M0WUT/KIO_WUT/Hardware/usb_hub_test.brd

## EAGLE design Hardware/usb_hub_test.brd (2019-03-14)

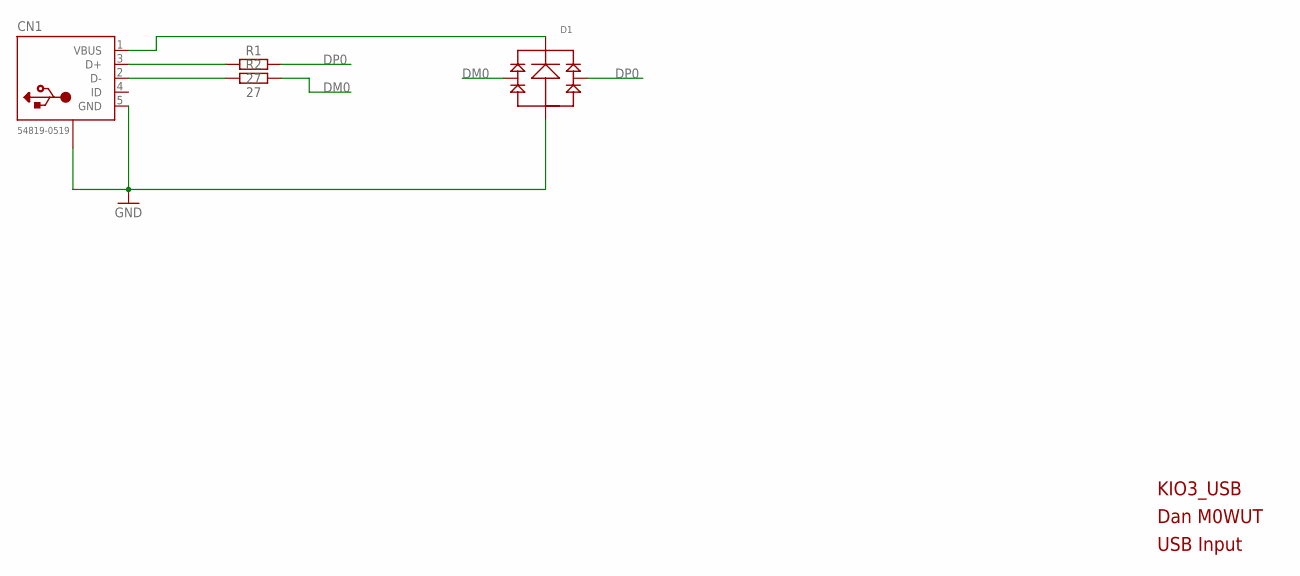
[picture p1: schematic usb_hub_test.sch, sheet 1, USB Input]

Parts:
CN1: 54819-0519; CONN_AMP_MUSB_K152
D1: D_ST_USBULC6; UQFN6
R1, R2: 27; R0402

Connections:
D+_P: CN1.3 (D+), R1.1
DM0: D1.1 (LEFT), D1.6 (LEFT), R2.2; also elsewhere on the board
DP0: D1.3 (RIGHT), D1.4 (RIGHT), R1.2; also elsewhere on the board
GND: CN1.5 (GND), CN1.GND1 (SHIELD), CN1.GND2 (SHIELD), D1.2 (GND); also elsewhere on the board
unnamed: CN1.2 (D-), R2.1
VBUS: CN1.1 (VBUS), D1.5 (V+)

Notes on the sheet:
KIO3_USB
Dan M0WUT
USB Input

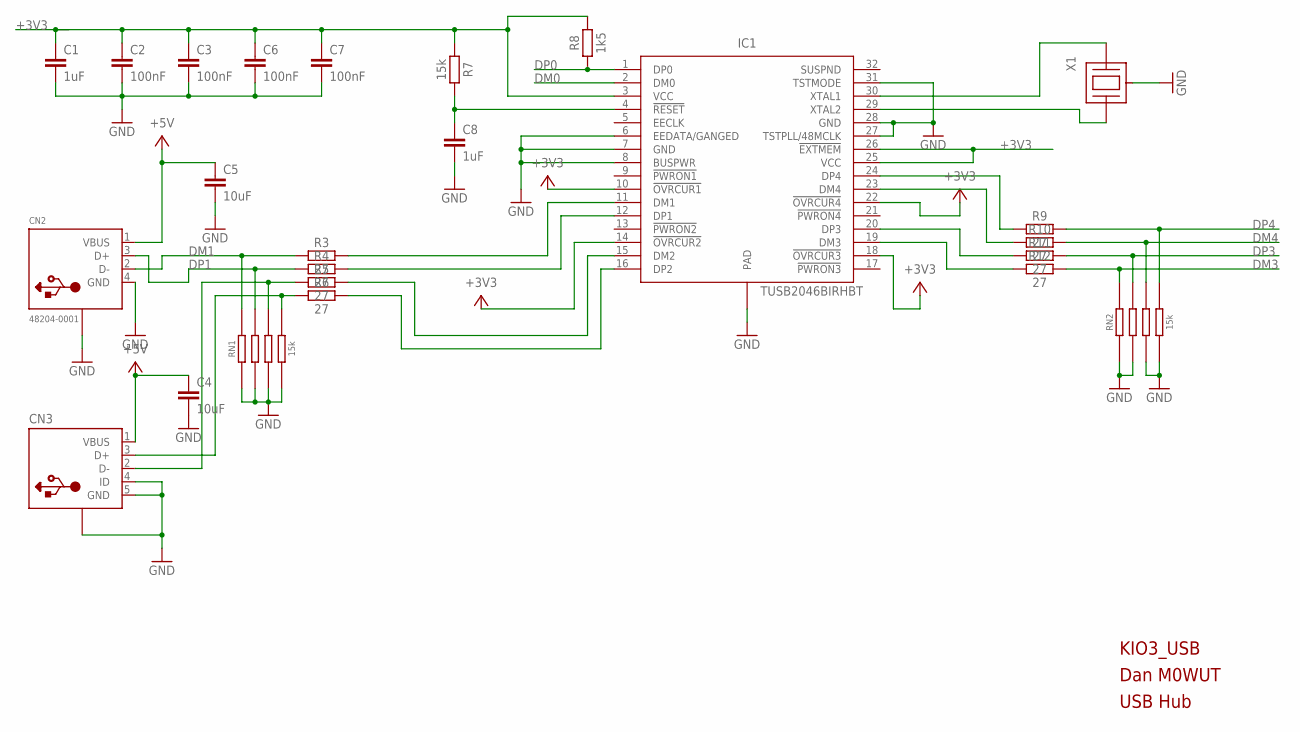
[picture p2: schematic usb_hub_test.sch, sheet 2, USB Hub]

Parts:
C1, C8: 1uF; C0402
C2, C3, C6, C7: 100nF; C0402
C4, C5: 10uF; C0805
CN2: 48204-0001; CONN_USB_MOLEX_RA
CN3: USBWURTH; USB_MICROB_WURTH
IC1: TUSB2046BIRHBT; RHB_S-PQFP-N32
R3, R4, R5, R6, R9, R10, R11, R12: 27; R0402
R7: 15k; R0402
R8: 1k5; R0402
RN1, RN2: 15k; R_BOURNS_CAY16-J4
X1: XTAL_MURATA_3-PIN-RES

Connections:
+3V3: C1.1, C2.1, C3.1, C6.1, C7.1, IC1.3 (VCC), IC1.10 (!OVRCUR1), IC1.14 (!OVRCUR2), IC1.18 (!OVRCUR3), IC1.22 (!OVRCUR4), IC1.25 (VCC), IC1.26 (!EXTMEM), R7.1, R8.2; also elsewhere on the board
+5V: C4.1, C5.1, CN2.1 (VBUS), CN3.1 (VBUS); also elsewhere on the board
DM0: IC1.2 (DM0); also elsewhere on the board
DM1: CN2.2 (D-), R3.1, RN1.1A
DM2: CN3.2 (D-), R5.1, RN1.3A
DM3: R12.2, RN2.1A; also elsewhere on the board
DM4: R10.2, RN2.3A; also elsewhere on the board
DP0: IC1.1 (DP0), R8.1; also elsewhere on the board
DP1: CN2.3 (D+), R4.1, RN1.2A
DP2: CN3.3 (D+), R6.1, RN1.4A
DP3: R11.2, RN2.2A; also elsewhere on the board
DP4: R9.2, RN2.4A; also elsewhere on the board
GND: C1.2, C2.2, C3.2, C4.2, C5.2, C6.2, C7.2, C8.2, CN2.4 (GND), CN2.P$2 (SHIELD), CN2.P$3 (SHIELD), CN2.P$4 (SHIELD), CN2.P$5 (SHIELD), CN3.4 (ID), CN3.5 (GND), CN3.GND1 (SHIELD), CN3.GND2 (SHIELD), CN3.GND3 (SHIELD), CN3.GND4 (SHIELD), IC1.6 (EEDATA/GANGED), IC1.7 (GND), IC1.8 (BUSPWR), IC1.27 (TSTPLL/48MCLK), IC1.28 (GND), IC1.31 (TSTMODE), IC1.EXP (PAD), RN1.1, RN1.2, RN1.3, RN1.4, RN2.1, RN2.2, RN2.3, RN2.4, X1.GND (CAN); also elsewhere on the board
unnamed: IC1.23 (DM4), R10.1
unnamed: IC1.24 (DP4), R9.1
unnamed: IC1.30 (XTAL1), X1.1 (XTAL1)
unnamed: C8.1, IC1.4 (!RESET), R7.2
unnamed: IC1.29 (XTAL2), X1.2 (XTAL2)
unnamed: IC1.15 (DM2), R5.2
unnamed: IC1.11 (DM1), R3.2
unnamed: IC1.12 (DP1), R4.2
unnamed: IC1.16 (DP2), R6.2
unnamed: IC1.20 (DP3), R11.1
unnamed: IC1.19 (DM3), R12.1

Notes on the sheet:
KIO3_USB
Dan M0WUT
USB Hub

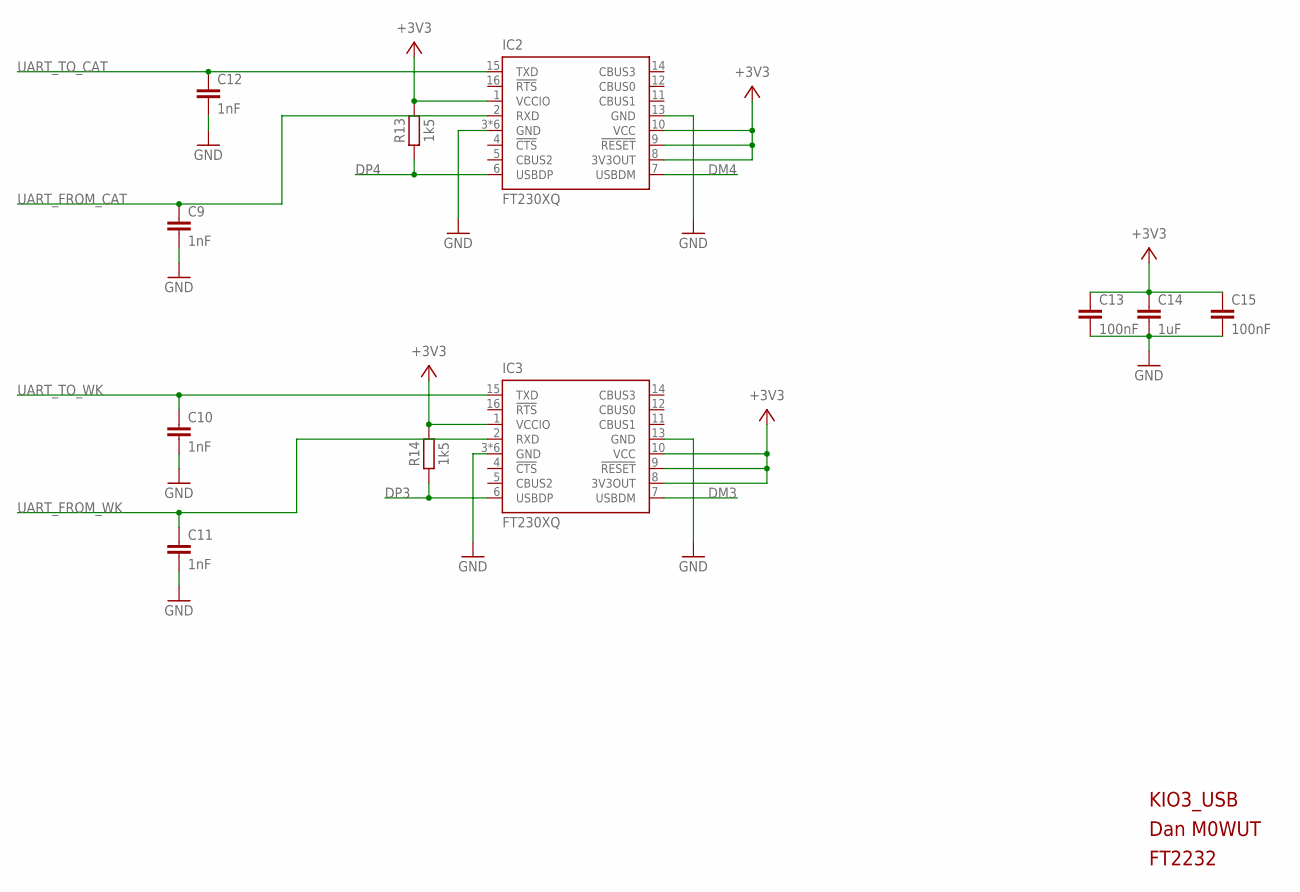
[picture p3: schematic usb_hub_test.sch, sheet 3, FT2232]

Parts:
C9, C10, C11, C12: 1nF; C0402
C13, C15: 100nF; C0402
C14: 1uF; C0402
IC2, IC3: FT230XQ; QFN16
R13, R14: 1k5; R0402

Connections:
+3V3: C13.1, C14.1, C15.1, IC2.1 (VCCIO), IC2.8 (3V3OUT), IC2.9 (!RESET), IC2.10 (VCC), IC3.1 (VCCIO), IC3.8 (3V3OUT), IC3.9 (!RESET), IC3.10 (VCC), R13.2, R14.2; also elsewhere on the board
DM3: IC3.7 (USBDM); also elsewhere on the board
DM4: IC2.7 (USBDM); also elsewhere on the board
DP3: IC3.6 (USBDP), R14.1; also elsewhere on the board
DP4: IC2.6 (USBDP), R13.1; also elsewhere on the board
GND: C9.2, C10.2, C11.2, C12.2, C13.2, C14.2, C15.2, IC2.3 (GND), IC2.13 (GND), IC2.P$1 (GND), IC2.P$2 (GND), IC2.P$3 (GND), IC2.P$4 (GND), IC2.TAB (GND), IC3.3 (GND), IC3.13 (GND), IC3.P$1 (GND), IC3.P$2 (GND), IC3.P$3 (GND), IC3.P$4 (GND), IC3.TAB (GND); also elsewhere on the board
UART_FROM_CAT: C9.1, IC2.2 (RXD); also elsewhere on the board
UART_FROM_WK: C11.1, IC3.2 (RXD); also elsewhere on the board
UART_TO_CAT: C12.1, IC2.15 (TXD); also elsewhere on the board
UART_TO_WK: C10.1, IC3.15 (TXD); also elsewhere on the board

Notes on the sheet:
KIO3_USB
Dan M0WUT
FT2232

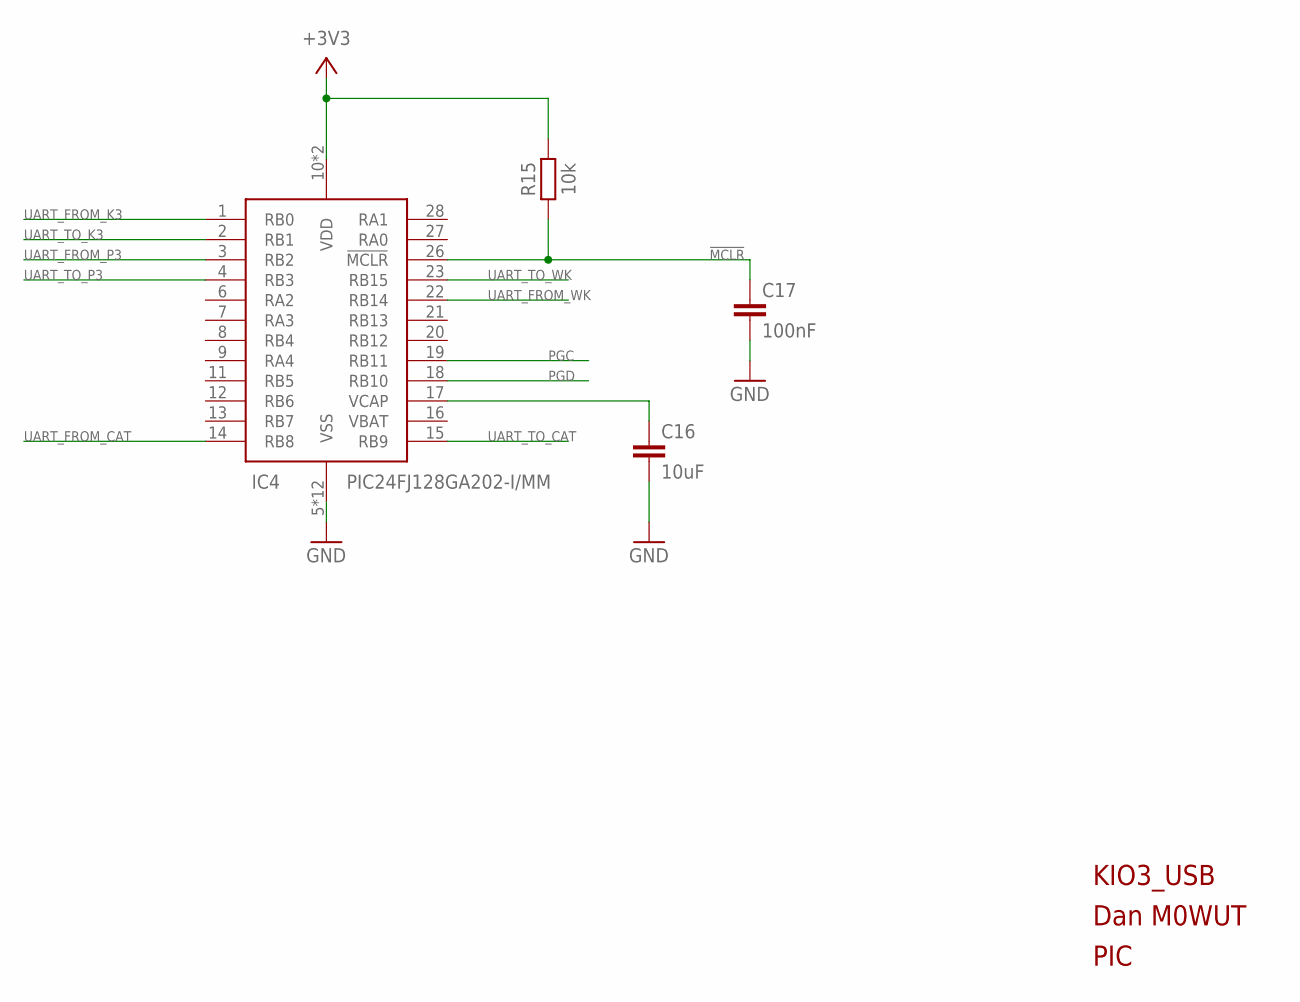
[picture p4: schematic usb_hub_test.sch, sheet 4, PIC]

Parts:
C16: 10uF; C0805
C17: 100nF; C0402
IC4: PIC24FJ128GA202-I/MM; QFN28-ML_6X6MM
R15: 10k; R0402

Connections:
!MCLR: C17.1, IC4.26 (!MCLR), R15.1
+3V3: IC4.10 (VDD), IC4.25 (VDD), R15.2; also elsewhere on the board
GND: C16.2, C17.2, IC4.5 (VSS), IC4.24 (VSS), IC4.EXP (VSS), IC4.P$1 (VSS), IC4.P$2 (VSS), IC4.P$3 (VSS), IC4.P$4 (VSS), IC4.P$5 (VSS), IC4.P$6 (VSS), IC4.P$7 (VSS), IC4.P$9 (VSS), IC4.P$10 (VSS); also elsewhere on the board
unnamed: C16.1, IC4.17 (VCAP)
PGC: IC4.19 (RB11)
PGD: IC4.18 (RB10)
UART_FROM_CAT: IC4.14 (RB8); also elsewhere on the board
UART_FROM_K3: IC4.1 (RB0); also elsewhere on the board
UART_FROM_P3: IC4.3 (RB2); also elsewhere on the board
UART_FROM_WK: IC4.22 (RB14); also elsewhere on the board
UART_TO_CAT: IC4.15 (RB9); also elsewhere on the board
UART_TO_K3: IC4.2 (RB1); also elsewhere on the board
UART_TO_P3: IC4.4 (RB3); also elsewhere on the board
UART_TO_WK: IC4.23 (RB15); also elsewhere on the board

Notes on the sheet:
KIO3_USB
Dan M0WUT
PIC

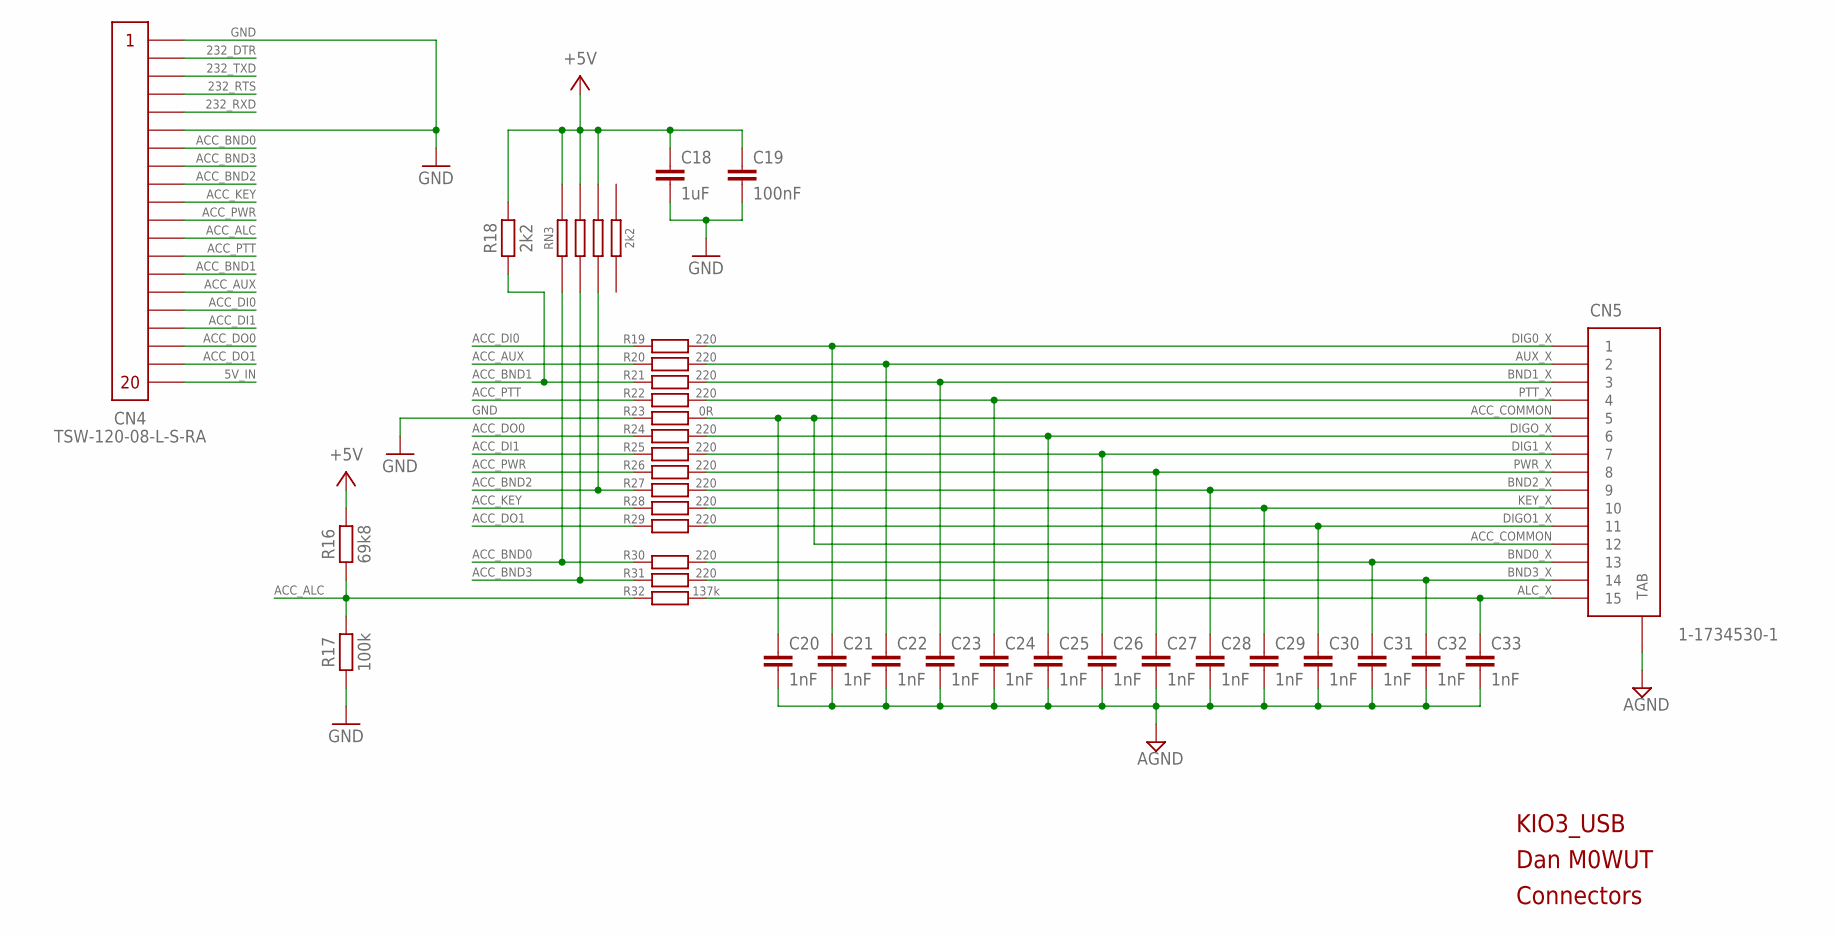
[picture p5: schematic usb_hub_test.sch, sheet 5, Connectors]

Parts:
C18: 1uF; C0402
C19: 100nF; C0402
C20, C21, C22, C23, C24, C25, C26, C27, C28, C29, C30, C31, C32, C33: 1nF; C0402
CN4: TSW-120-08-L-S-RA; CONN_0.1_1X20
CN5: 1-1734530-1; CONN_TE_DE-HD15
R16: 69k8; R0402
R17: 100k; R0402
R18: 2k2; R0402
R19, R20, R21, R22, R24, R25, R26, R27, R28, R29, R30, R31: 220; R0402
R23: 0R; R0402
R32: 137k; R0402
RN3: 2k2; R_BOURNS_CAY16-J4

Connections:
5V_IN: CN4.P$20; also elsewhere on the board
232_DTR: CN4.P$2
232_RTS: CN4.P$4
232_RXD: CN4.P$5; also elsewhere on the board
232_TXD: CN4.P$3; also elsewhere on the board
+5V: C18.1, C19.1, R16.2, R18.2, RN3.1, RN3.2, RN3.3; also elsewhere on the board
ACC_ALC: CN4.P$12, R16.1, R17.2, R32.1
ACC_AUX: CN4.P$15, R20.1
ACC_BND0: CN4.P$7, R30.1, RN3.1A
ACC_BND1: CN4.P$14, R18.1, R21.1
ACC_BND2: CN4.P$9, R27.1, RN3.3A
ACC_BND3: CN4.P$8, R31.1, RN3.2A
ACC_COMMON: C20.1, CN5.5, CN5.12, R23.2
ACC_DI0: CN4.P$16, R19.1
ACC_DI1: CN4.P$17, R25.1
ACC_DO0: CN4.P$18, R24.1
ACC_DO1: CN4.P$19, R29.1
ACC_KEY: CN4.P$10, R28.1
ACC_PTT: CN4.P$13, R22.1
ACC_PWR: CN4.P$11, R26.1
AGND: C20.2, C21.2, C22.2, C23.2, C24.2, C25.2, C26.2, C27.2, C28.2, C29.2, C30.2, C31.2, C32.2, C33.2, CN5.16 (TAB), CN5.17 (TAB); also elsewhere on the board
ALC_X: C33.1, CN5.15, R32.2
AUX_X: C22.1, CN5.2, R20.2
BND0_X: C31.1, CN5.13, R30.2
BND1_X: C23.1, CN5.3, R21.2
BND2_X: C28.1, CN5.9, R27.2
BND3_X: C32.1, CN5.14, R31.2
DIG0_X: C21.1, CN5.1, R19.2
DIG1_X: C26.1, CN5.7, R25.2
DIGO1_X: C30.1, CN5.11, R29.2
DIGO_X: C25.1, CN5.6, R24.2
GND: C18.2, C19.2, CN4.P$1, CN4.P$6, R17.1, R23.1; also elsewhere on the board
KEY_X: C29.1, CN5.10, R28.2
PTT_X: C24.1, CN5.4, R22.2
PWR_X: C27.1, CN5.8, R26.2

Notes on the sheet:
KIO3_USB
Dan M0WUT
Connectors

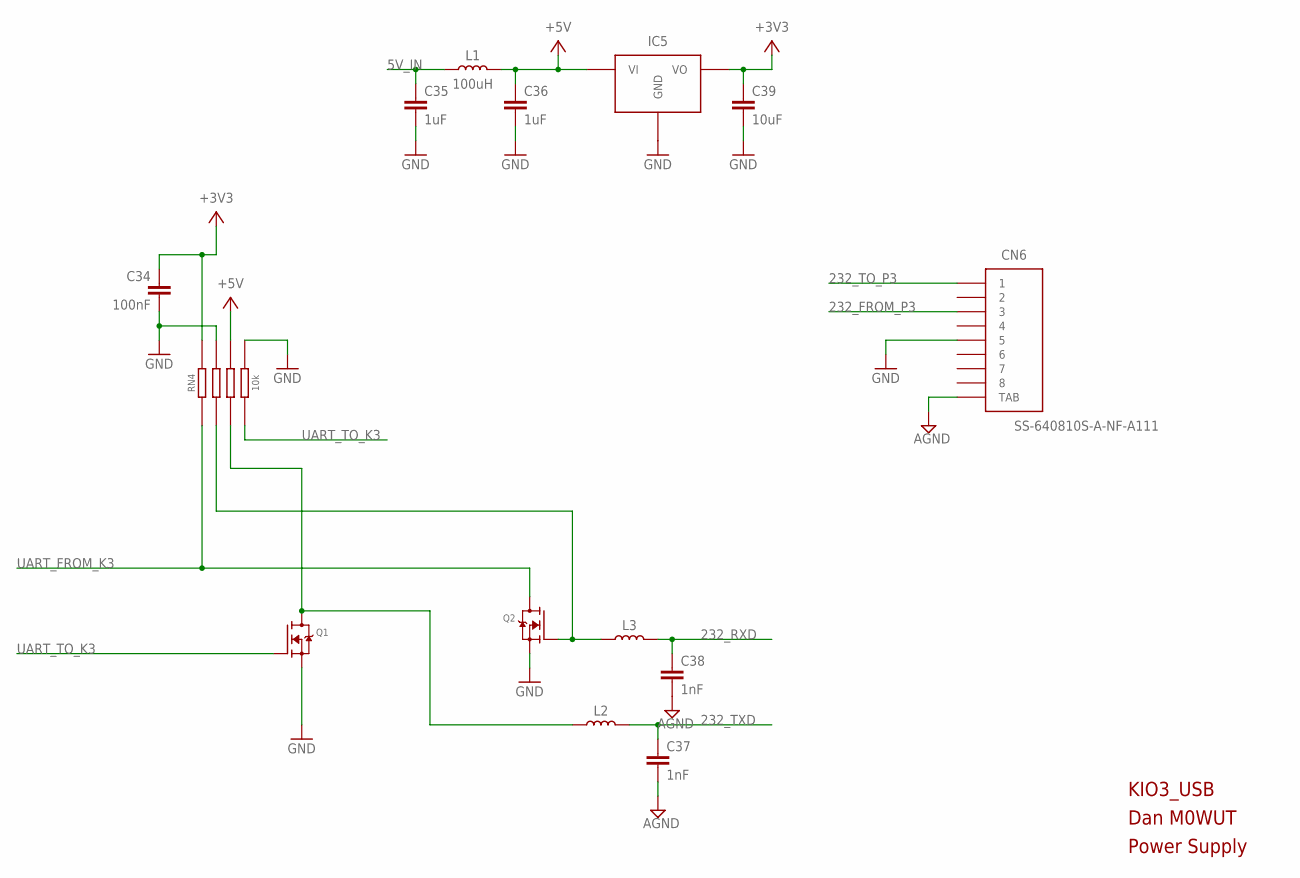
[picture p6: schematic usb_hub_test.sch, sheet 6]

Parts:
C34: 100nF; C0402
C35, C36: 1uF; C0402
C37, C38: 1nF; C0402
C39: 10uF; C0805
CN6: SS-640810S-A-NF-A111; CONN_STEWART_RJ45_1
IC5: MCP1700; SOT23
L1: 100uH; R0805
L2, L3: INDUCTOR; R0805
Q1, Q2: MOSFET-NREFLOW; SOT23
RN4: 10k; R_BOURNS_CAY16-J4

Connections:
5V_IN: C35.1, L1.1; also elsewhere on the board
232_FROM_P3: CN6.3; also elsewhere on the board
232_RXD: C38.1, L3.2; also elsewhere on the board
232_TO_P3: CN6.1; also elsewhere on the board
232_TXD: C37.1, L2.2; also elsewhere on the board
+3V3: C34.1, C39.1, IC5.BOTTOM_RIGHT (VO), RN4.1A; also elsewhere on the board
+5V: C36.1, IC5.TOP (VI), L1.2, RN4.3A; also elsewhere on the board
AGND: C37.2, C38.2, CN6.TAB, CN6.TAB1 (TAB); also elsewhere on the board
ASDF: L2.1, Q1.3 (D), RN4.3
GND: C34.2, C35.2, C36.2, C39.2, CN6.5, IC5.BOTTOM_LEFT (GND), Q1.2 (S), Q2.2 (S), RN4.2A, RN4.4A; also elsewhere on the board
SADF: L3.1, Q2.1 (G), RN4.2
UART_FROM_K3: Q2.3 (D), RN4.1; also elsewhere on the board
UART_TO_K3: Q1.1 (G), RN4.4; also elsewhere on the board

Notes on the sheet:
KIO3_USB
Dan M0WUT
Power Supply

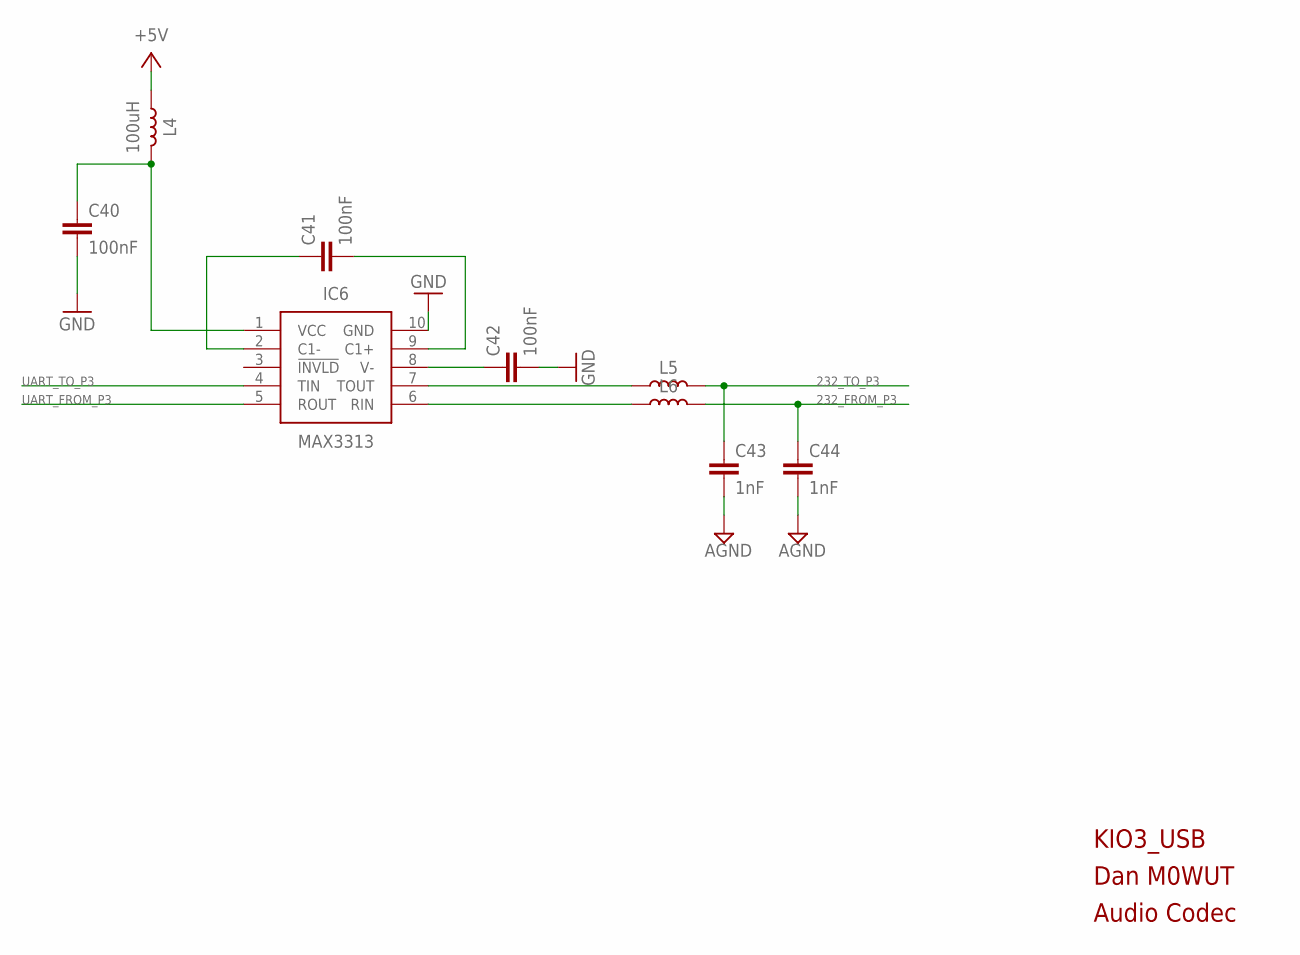
[picture p7: schematic usb_hub_test.sch, sheet 7]

Parts:
C40, C41, C42: 100nF; C0402
C43, C44: 1nF; C0402
IC6: IC_MAX3313; IC_UMAX10
L4: 100uH; R0805
L5, L6: INDUCTOR; R0805

Connections:
232_FROM_P3: C44.1, L6.2; also elsewhere on the board
232_TO_P3: C43.1, L5.2; also elsewhere on the board
+5V: L4.1; also elsewhere on the board
AGND: C43.2, C44.2; also elsewhere on the board
GND: C40.2, C42.2, IC6.10 (GND); also elsewhere on the board
unnamed: C40.1, IC6.1 (VCC), L4.2
unnamed: C41.1, IC6.2 (C1-)
unnamed: C41.2, IC6.9 (C1+)
unnamed: C42.1, IC6.8 (V-)
UART_FROM_P3: IC6.5 (ROUT); also elsewhere on the board
UART_TO_P3: IC6.4 (TIN); also elsewhere on the board
WTRE: IC6.7 (TOUT), L5.1
Y5W4: IC6.6 (RIN), L6.1

Notes on the sheet:
KIO3_USB
Dan M0WUT
Audio Codec

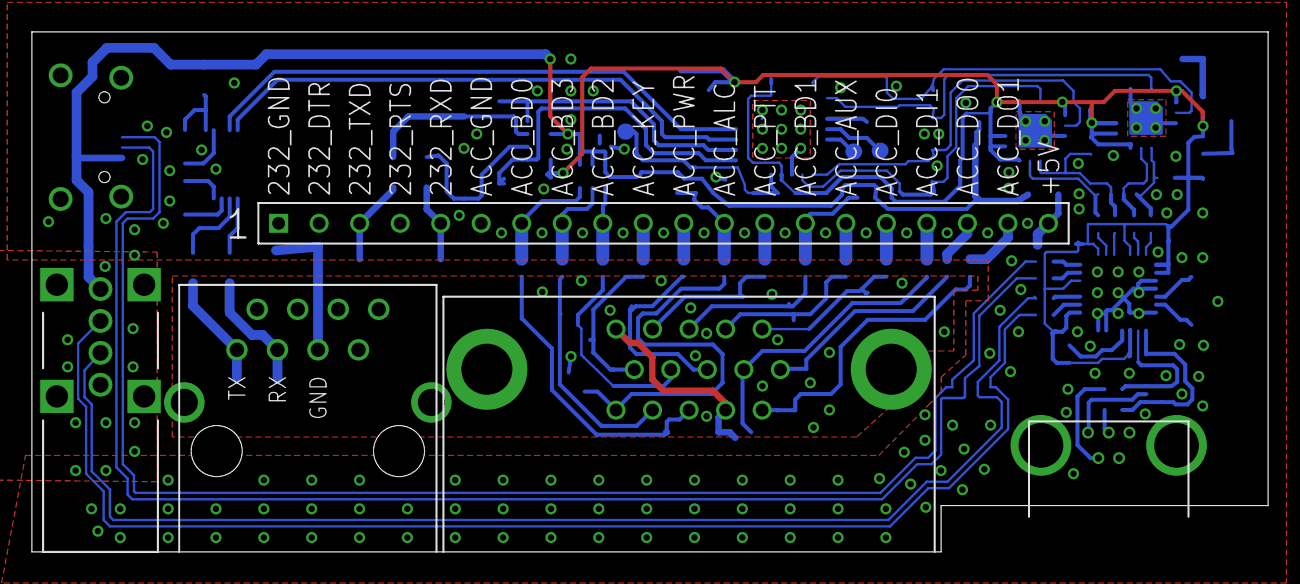
[picture p8: board usb_hub_test.brd from above]

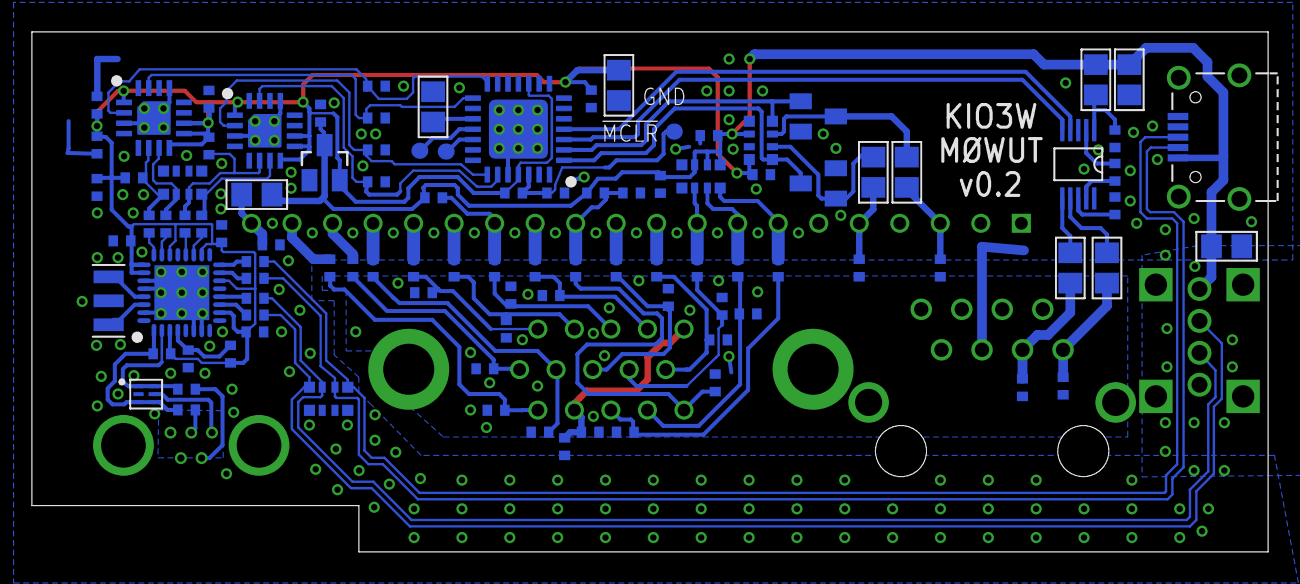
[picture p9: board usb_hub_test.brd from below]

Board: 2 copper layers, 77.5 x 32.6 mm, 102 parts (97 on the bottom side), 78 nets.
