M0WUT/KIO_WUT/(commit log)

2018-10-08 added ft2232
    [v1.brd, v1.sch]
2018-10-18 added eeprom and expanded sch
    [v1.brd, v1.sch]
2018-10-31 Resized PCB now I have reference board
    [v1.brd, v1.sch]
2018-11-04 finished input side of usb isolator
    [v1.brd, v1.sch]
2018-11-05 most of usb hub implemented
    [v1.brd, v1.sch]
2018-11-11 mirrored digital section of board to allow for easier routing to io
    [v1.brd, v1.sch]
2018-11-27 finally got the decoupling caps for the db15 to fit
    [v1.brd, v1.sch]
2018-11-29 reorganised decoupling caps to be slightly less crazy
    [v1.brd]
2018-12-01 fixed some silkscreen issues
    [v1.brd, v1.sch]
2018-12-01 added missing pullups to band lines
    [v1.brd, v1.sch]
2018-12-02 complete apart from sound card and PIC
    [v1.brd, v1.sch]
2018-12-12 destruction in the name of progress...
    [v1.brd, v1.sch]
2019-01-07 nearly there...
    [usb_hub_test.brd, usb_hub_test.sch, v1.brd]
2019-01-24 Initial changes from v1 + started code
    [usb_hub_test.brd, usb_hub_test.sch]
2019-01-27 Started work but fighting Microchip's stupid library
    [usb_hub_test.brd, usb_hub_test.sch]
2019-01-29 All 4 UARTS TXing
    [usb_hub_test.brd]
2019-01-31 loopback tests working
    [usb_hub_test.brd]
2019-02-01 All the forwarding between devices working :)
2019-02-13 Implementing Board changes from v1
    [usb_hub_test.brd, usb_hub_test.sch]
2019-02-18 v2 pcb ordered
    [usb_hub_test.brd, usb_hub_test.sch]
2019-02-18 Update with a change that I wish was in v2
    [usb_hub_test.brd, usb_hub_test.sch]
2019-03-07 renumbered parts, minor BOM update
    [usb_hub_test.brd, usb_hub_test.sch]
2019-03-14 minor code fixes
    [usb_hub_test.brd, usb_hub_test.sch]
